tmpk13/pico-step/README.md

# pico-step

Closed-loop stepper driver board: RP2354A + TMC5241 motion controller and
driver (integrated 65 V bridges) + TLE5012B magnetic angle sensor.
USB-C powered logic, separate motor supply (VM) up to 48 V.

The schematic is drawn as text in `tsch/` for the text-schematic tool
`tsch` (set `TSCH` to its binary when it is not on the PATH); `mise run sch`
builds it into `pico-step.kicad_sch`, which is generated and not committed.

```sh
mise run install   # test deps
mise run sch-check # check the tsch/ drawing (fast, no KiCad)
mise run sch       # tsch/ -> pico-step.kicad_sch + sheets, proven with kicad-cli
mise run erc
mise run test
mise run render    # build/tsch/pico-step-<sheet>.png
mise run pcb-sync  # board <- schematic (footprints, values, nets), keeps placement
mise run pcb-place # placement table -> board (overwrites GUI moves)
mise run pcb-dsn   # build/pico-step.dsn for freerouting
mise run pcb-autoroute # FREEROUTING=<launcher or jar> freerouting -> build/pico-step.ses
mise run pcb-ses   # import the session and refill zones
mise run pcb-gnd   # GND stitching vias after routing
mise run pcb-drc
mise run pcb-render # build/pcb-top.png, build/pcb-bottom.png
```

The PCB is a 42 mm NEMA17 back-mount, 2 layers, 0.15 mm rules; the floor
plan is in `notes/pcb.md`.

See `ARCHITECTURE.md` for the block diagram, `BOM.md` for sourced parts,
`PARTS_BY_CHIP.md` for which parts support which chip,
`DIGIKEY.md` for the order list,
`TODO.md` for open work.
