tmpk13/pico-step/NOTES.md

# Notes

One topic per file. Read this index, then only the files the task touches.

- `notes/driver.md`: TMC5241 data sheet and package, running at 48 V, the EVKIT reference design, pin strapping.
- `notes/circuit.md`: the TLE5012B DATA line on the RP2354A SPI, its E5000 variant and PG-DSO-8 land pattern, the USB-C shield pin, power, MCU choice, the RP2354A.
- `notes/schematic.md`: the tsch/ text drawing that builds the schematic, net names and net classes, the swap from the hand-placed schematic, the DigiKey list.
- `notes/pcb.md`: pcbnew scripting under KiCad 10.0.4, the floor plan, the routing result.
