tmpk13/pico-step/digikey_list.csv

Quantity | Part Number | Manufacturer | Customer Reference | Description
1 | SC1511-A4 | Raspberry Pi | U1 | RP2354A MCU with 2 MB flash, QFN-60
1 | AP2112K-3.3TRG1 | Diodes Inc. | U2 | 3.3 V LDO, SOT-23-5
1 | TLE5012BE5000XUMA1 | Infineon | U3 | Magnetic angle sensor, DSO-8
1 | TMC5241ATU+T | Analog Devices | U5 | Stepper controller and driver, 65 V 2 A RMS integrated bridges, TQFN-38-EP 5x7
1 | ABM8-272-T3 | Abracon | Y1 | 12 MHz crystal, CL 10 pF, 3225
1 | AOTA-B201610S3R3-101-T | Abracon | L1 | 3.3u shielded inductor, polarity marked, 2.0x1.6 mm
1 | USB4105-GF-A | GCT | J1 | USB-C receptacle
1 | 1729128 | Phoenix Contact | J2 | 2-pos terminal block, 5.08 mm
1 | PRPC003SAAN-RC | Sullins | J3 | 1x3 header, 2.54 mm (SWD)
1 | B4B-XH-A | JST | J4 | 4-pos XH header
1 | LTST-C191KGKT | Lite-On | D1 | Green LED, 0603
2 | PTS810SJM250SMTR LFS | C&K | SW1 SW2 | Tactile switch
2 | RC0603FR-075K1L | Yageo | R1 R2 | 5.1k 1% 0603
2 | RC0603FR-0727RL | Yageo | R3 R4 | 27R 1% 0603
2 | RC0603FR-071KL | Yageo | R5 R6 | 1k 1% 0603
5 | RC0603FR-1310KL | Yageo | R7 R16 R17 R24 R25 | 10k 1% 0603
1 | RC0603FR-13330RL | Yageo | R8 | 330R 1% 0603
2 | RC0603FR-10100RL | Yageo | R9 R10 | 100R 1% 0603
1 | RC0603FR-07470RL | Yageo | R11 | 470R 1% 0603
1 | RC0603FR-10100KL | Yageo | R12 | 100k 1% 0603
1 | RC0603FR-075K6L | Yageo | R13 | 5.6k 1% 0603
1 | RC0603FR-074K7L | Yageo | R14 | 4.7k 1% 0603
1 | RC0603FR-0712KL | Yageo | R15 | 12k 1% 0603 (RREF, full-scale current)
1 | RC0603FR-0733RL | Yageo | R27 | 33R 1% 0603
1 | GRM188R61A105KA61D | Murata | C1 | 1u 10V X5R 0603
13 | GCM188R71H104KA57D | Murata | C3 C4 C5 C6 C7 C8 C9 C10 C13 C14 C18 C20 C26 | 100n 50V X7R 0603
4 | GRM188R61E475KE11D | Murata | C11 C12 C17 C36 | 4.7u 25V X5R 0603
2 | GCJ188R72A104KA01D | Murata | C21 C22 | 100n 100V X7R 0603
1 | CL10B105KA8VPNC | Samsung | C23 | 1u 25V X7R 0603
2 | CC0603JRNPO9BN150 | Yageo | C15 C16 | 15p 50V C0G 0603
1 | CL10B223KC8WPNC | Samsung | C24 | 22n 100V X7R 0603
1 | GRM188R71A225KE15D | Murata | C25 | 2.2u 10V X7R 0603
2 | C1210C225K1RACTU | KEMET | C33 C34 | 2.2u 100V X7R 1210
1 | GRM21BZ71C106ME15L | Murata | C2 | 10u 16V X7R 0805 (20%)
2 | 63SGV100M10X10.5 | Rubycon | C19 C35 | 100u 63V electrolytic, SMD 10x10.5
