tmpk13/pico-step/TODO_complete.md

# Completed

- RP2040 core, USB-C + 3V3 LDO, TLE5012B on SPI1, VM input + sense: schematic generated, ERC clean.
- Project footprints: Infineon PG-DSO-8 (data sheet land pattern), USB4105 with SH shield pads.
- TMC2240: symbol from data sheet pin table (all 33 pins tested), driver block per Figure 35, motor connector J4.
- MCU swapped RP2040 -> ESP32-C5HF4: symbol from data sheet v1.5 (49 pins tested), supply/crystal/CHIP_PU/BOOT per Espressif reference, RF CLC + Murata diplexer (land pattern from spec CD481-01) + U.FL, TLE5012B moved onto the shared SPI bus, strapping-pin rules tested.
- RF path parts renamed with `_rf` suffix (generator, schematic, PCB, BOM/DigiKey docs); parts-by-chip list in PARTS_BY_CHIP.md; reference consistency tests.
- MCU swapped back ESP32-C5HF4 -> RP2040 (generator, symbols, footprints, tests and docs as before the swap; ESP32 version kept in git at 738db68). DigiKey list and parts-by-chip list redone for RP2040 (56 parts), order list coverage test.
- Hand-placed schematic restored (738db68) with the ESP32 block removed and the RP2040 block pasted below; ERC clean, netlist matches circuit.py apart from the existing hand edits. `mise run sch` now writes to build/, `mise run parity` added.
- Driver swapped TMC2240 -> TMC5160A-TA for VM up to 48 V: symbol from data sheet rev 1.18 (49 pins tested), stock TQFP-48-EP footprint (EP matches the data sheet), 8x CSD19537Q3 bridges with 0.1R sense, Figure 3.1 support parts, per-bridge wiring test. Pasted in place into the hand-placed schematic (A1 sheet), ERC clean, parity shows only the existing hand edits. VM parts re-rated for 48 V (C19 63 V, VM_SENSE 100k/5.6k). DigiKey list 82 parts.
- Dropped: TMC2240 TQFN exposed pad check (part removed).
- MCU swapped RP2040 -> RP2354A (2 MB in-package flash, W25Q128 U4 removed): pinout checked against the RP2350 data sheet, switching core regulator per data sheet 6.3.8 (L1 polarity-marked inductor with a project footprint, R27/C17 VREG_AVDD filter, 4.7u CIN/COUT, C36 on DVDD 23). Swapped in place in the hand-placed schematic (U1 position and uuid kept, old pin labels reused); ERC clean, parity shows only the existing hand edits. DigiKey list 84 parts.
- Bridge FETs 8x CSD19537Q3 -> 4x SQJB68EP dual (one per half bridge) for cost at 5-board quantities; project footprint from Vishay doc 63817 with a data sheet test, stock dual symbol as two units placed where the old singles were (no wires moved). RSENSE 0.1 -> 0.15 (1.6 A RMS full scale) to keep standstill FET heat near 0.7 W; short-detect levels noted. ERC clean, parity shows only the existing hand edits. DigiKey list 80 parts.
- PCB updated from the schematic; every part placed (`tools/pcb_place.py`).
- PCB: TLE5012B on the back at the shaft axis (board center).
- Driver swapped TMC5160A + 4x SQJB68EP -> TMC5241 (integrated 65 V bridges, 2 A RMS): symbol from data sheet rev 0 (39 pins tested), project TQFN-38 footprint from land pattern 90-0076 rev C with 0.3 mm thermal vias (tested), Figure 50 support parts (RREF 12k, 100 V charge pump cap), nSLEEP on GPIO18. Swapped in place in the hand-placed schematic (ERC clean, parity shows only the existing hand edits); board synced from the schematic with the new `pcb-sync` task, placement kept. DigiKey list 63 parts. Old TMC5160A placement table entries, the FET pre-route script and the Vishay footprint removed.
- DigiKey list checked line by line for 5 boards (2026-11-09), including the resistors never searched; eight parts with no stock replaced (DIGIKEY.md).
- Schematic swapped to the tsch/ text drawing (four sheets, RP2354A as two units): `mise run sch` builds and proves it with kicad-cli and refuses to overwrite a schematic saved from KiCad; it matched the hand-placed schematic on all 54 nets before the swap. tools/circuit.py, kicad-vis layout, symbols.py and parity retired; tests read the built netlist. Board synced (net classes follow the new net names), DRC unchanged.
- C11 and C12 set to 4.7u in the schematic and on the board (RP2350 data sheet 6.3.8).
