tmpk13/pico-step/pico-step.kicad_pcb

## KiCad design pico-step.kicad_pcb (2026-11-10)

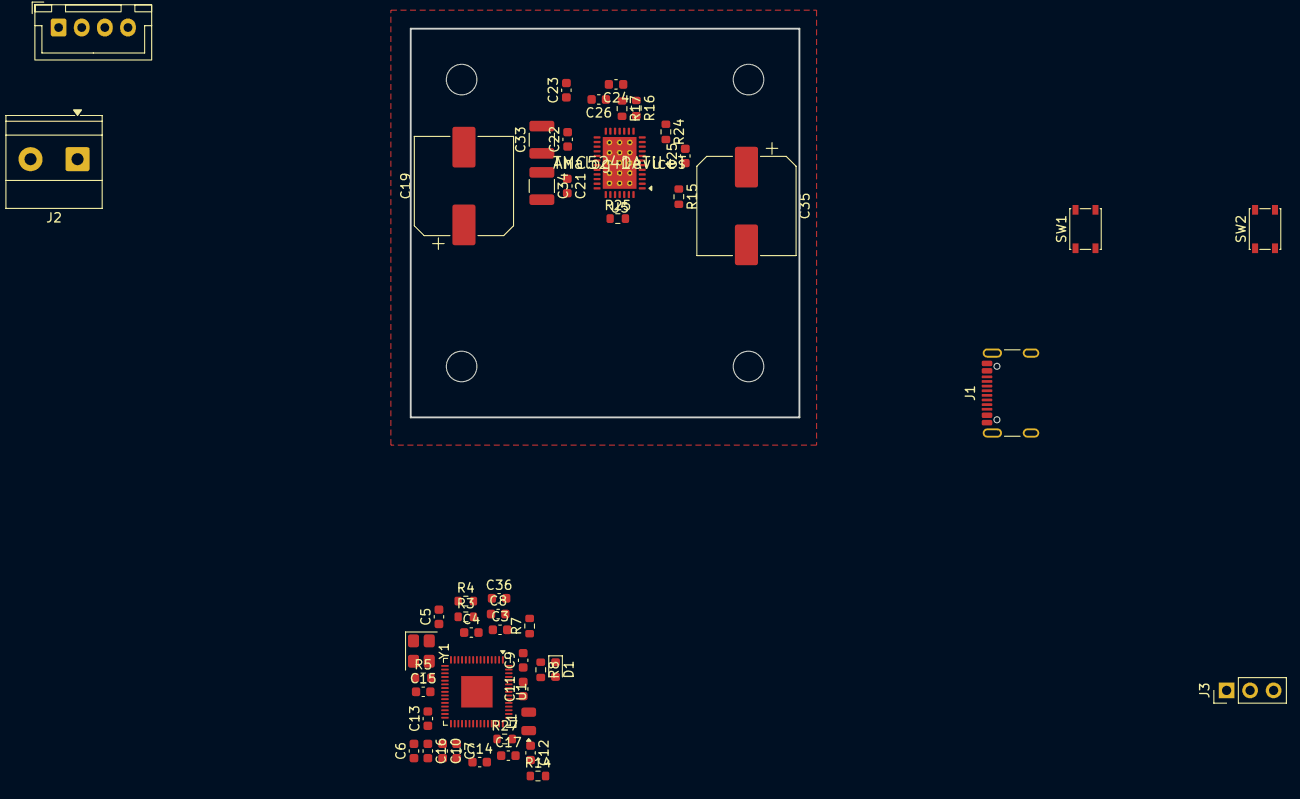
[picture p1: board pico-step.kicad_pcb from above]

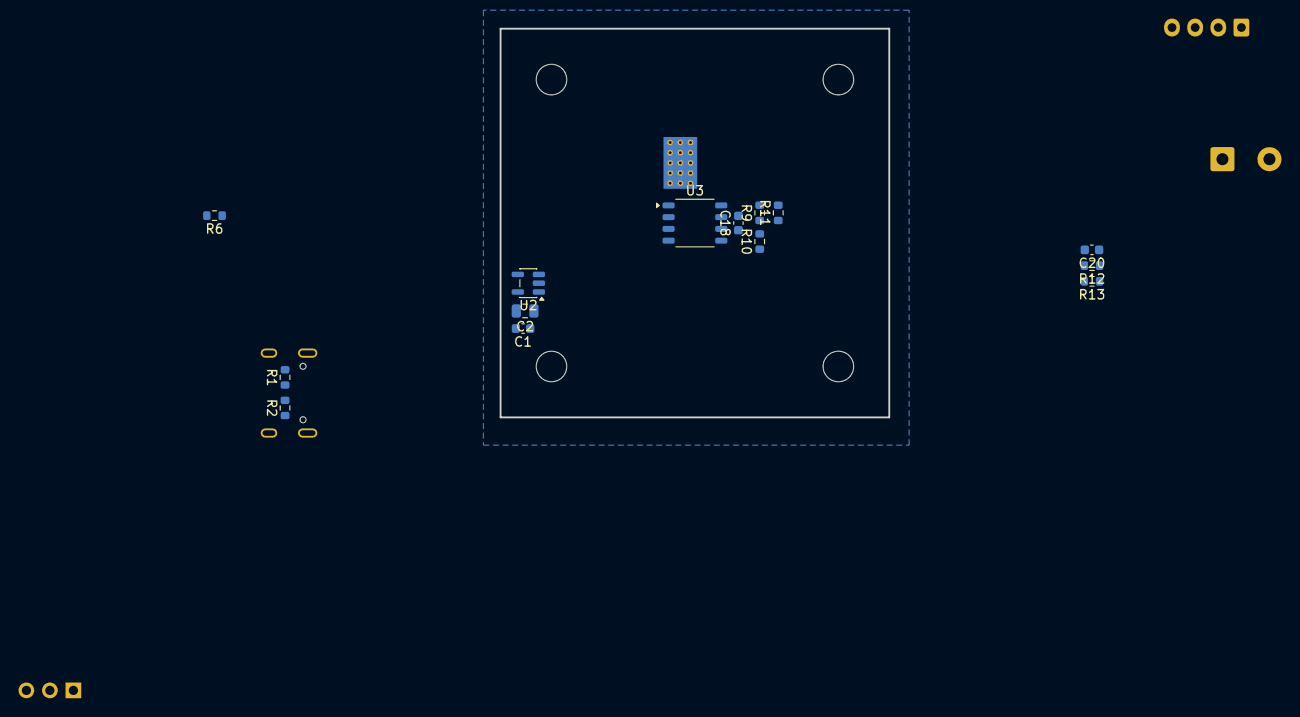
[picture p2: board pico-step.kicad_pcb from below]

Board: 4 copper layers, 42.0 x 42.0 mm, 63 parts (14 on the bottom side), 54 nets, no tracks yet.

Parts:
C1: 1u; C_0603_1608Metric
C2: 10u; C_0805_2012Metric
C3, C4, C5, C6, C7, C8, C9, C10, C13, C14, C18, C20, C26: 100n; C_0603_1608Metric
C11, C12, C17, C36: 4.7u; C_0603_1608Metric
C15, C16: 15p; C_0603_1608Metric
C19, C35: 100u 63V; CP_Elec_10x10.5
C21, C22: 100n 100V; C_0603_1608Metric
C23: 1u 25V; C_0603_1608Metric
C24: 22n 100V; C_0603_1608Metric
C25: 2.2u; C_0603_1608Metric
C33, C34: 2.2u 100V; C_1210_3225Metric
D1: LED; LED_0603_1608Metric
J1: USB-C; USB_C_Receptacle_GCT_USB4105-xx-A_16P_SH
J2: VM; TerminalBlock_Phoenix_MKDS-1,5-2-5.08_1x02_P5.08mm_Horizont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
J3: SWD; PinHeader_1x03_P2.54mm_Vertical
J4: Motor; JST_XH_B4B-XH-A_1x04_P2.50mm_Vertical
L1: 3.3u; L_Abracon_AOTA-B201610
R1, R2: 5.1k; R_0603_1608Metric
R3, R4: 27; R_0603_1608Metric
R5, R6: 1k; R_0603_1608Metric
R7, R16, R17, R24, R25: 10k; R_0603_1608Metric
R8: 330; R_0603_1608Metric
R9, R10: 100; R_0603_1608Metric
R11: 470; R_0603_1608Metric
R12: 100k; R_0603_1608Metric
R13: 5.6k; R_0603_1608Metric
R14: 4.7k; R_0603_1608Metric
R15: 12k; R_0603_1608Metric
R27: 33; R_0603_1608Metric
SW1: BOOTSEL; SW_SPST_PTS810
SW2: RESET; SW_SPST_PTS810
U1: RP2354A; QFN-60-1EP_7x7mm_P0.4mm_EP3.4x3.4mm
U2: AP2112K-3.3; SOT-23-5
U3: TLE5012BE5000; Infineon_PG-DSO-8
U5: TMC5241; ADI_TQFN-38-1EP_5x7mm_P0.5mm_EP3.65x5.6mm_ThermalVias
Y1: 12MHz; Crystal_SMD_3225-4Pin_3.2x2.5mm

Connections:
+1V1: C12.1, C13.1, C14.1, C36.1, L1.1, U1.6 (DVDD), U1.23 (DVDD), U1.39 (DVDD), U1.50 (VREG_FB)
+3V3: C2.1, C3.1, C4.1, C5.1, C6.1, C7.1, C8.1, C9.1, C10.1, C11.1, C18.1, C26.1, R7.1, R16.1, R17.1, R24.1, R27.1, U1.1 (IOVDD), U1.11 (IOVDD), U1.20 (IOVDD), U1.30 (IOVDD), U1.38 (IOVDD), U1.44 (ADC_AVDD), U1.45 (IOVDD), U1.49 (VREG_VIN), U1.53 (USB_OTP_VDD), U1.54 (QSPI_IOVDD), U2.5 (VOUT), U3.6 (VDD), U5.7 (VCC_IO)
/driver/OUT1A: J4.1, U5.29 (OUT1A)
/driver/OUT1B: J4.3, U5.22 (OUT1B)
/driver/OUT2A: J4.2, U5.27 (OUT2A)
/driver/OUT2B: J4.4, U5.24 (OUT2B)
ENC_CSQ: R10.1, U1.17 (GPIO13)
ENC_DATA: R11.1, R14.2, U1.16 (GPIO12)
ENC_IFA: U1.18 (GPIO14), U3.5 (IFA), U5.10 (ENCA)
ENC_IFB: U1.19 (GPIO15), U3.8 (IFB), U5.9 (ENCB)
ENC_IFC: U1.27 (GPIO16), U3.1 (IFC), U5.8 (ENCN)
ENC_SCK: R9.1, U1.14 (GPIO10)
ENC_TX: R14.1, U1.15 (GPIO11)
GND: C1.2, C2.2, C3.2, C4.2, C5.2, C6.2, C7.2, C8.2, C9.2, C10.2, C11.2, C12.2, C13.2, C14.2, C15.2, C16.2, C17.2, C18.2, C19.2, C20.2, C21.2, C22.2, C25.2, C26.2, C33.2, C34.2, C35.2, C36.2, D1.1 (K), J1.A1 (GND), J1.A12 (GND), J1.B1 (GND), J1.B12 (GND), J1.SH (SHIELD), J2.2, J3.2, R1.2, R2.2, R13.2, R15.2, R25.2, SW1.2, SW2.2, U1.47 (VREG_PGND), U1.61 (GND), U2.2 (GND), U3.7 (GND), U5.4 (AIN), U5.6 (AGND), U5.12 (UART_EN), U5.19 (NC), U5.20 (NC), U5.23 (PGND), U5.28 (PGND), U5.31 (NC), U5.32 (NC), U5.38 (CLK), U5.39 (EP), Y1.2 (G), Y1.4 (G)
unnamed: C16.1, R5.2, Y1.3
unnamed: D1.2 (A), R8.1
unnamed: J1.A5 (CC1), R1.1
unnamed: J1.B5 (CC2), R2.1
unnamed: J1.A6 (D+), J1.B6 (D+), R3.1
unnamed: J1.A7 (D-), J1.B7 (D-), R4.1
unnamed: J3.1, U1.24 (SWCLK)
unnamed: J3.3, U1.25 (SWDIO)
unnamed: R6.1, SW1.1
unnamed: C17.1, R27.2, U1.46 (VREG_AVDD)
unnamed: L1.2, U1.48 (VREG_LX)
unnamed: R8.2, U1.37 (GPIO25)
unnamed: R6.2, U1.60 (~QSPI_SS)
unnamed: R7.2, SW2.1, U1.26 (RUN)
unnamed: C15.1, U1.21 (XIN), Y1.1
unnamed: R5.1, U1.22 (XOUT)
unnamed: C1.1, J1.A4 (VBUS), J1.A9 (VBUS), J1.B4 (VBUS), J1.B9 (VBUS), U2.1 (VIN), U2.3 (EN)
unnamed: R10.2, U3.3 (CSQ)
unnamed: R11.2, U3.4 (DATA)
unnamed: R9.2, U3.2 (SCK)
unnamed: C24.1, U5.16 (CPI)
unnamed: C24.2, U5.17 (CPO)
unnamed: R16.2, U5.13 (DIAG0)
unnamed: R17.2, U5.14 (DIAG1_SW)
unnamed: R15.1, U5.3 (IREF)
unnamed: C23.2, U5.18 (VCP)
unnamed: C25.1, U5.5 (VDD1V8)
TMC_CSN: U1.8 (GPIO5), U5.34 (CSN_AD2)
TMC_ENN: R24.2, U1.12 (GPIO8), U5.11 (DRV_ENN)
TMC_REFL: U1.9 (GPIO6), U5.1 (REFL)
TMC_REFR: U1.10 (GPIO7), U5.2 (REFR)
TMC_SCK: U1.4 (GPIO2), U5.35 (SCK_AD1)
TMC_SDI: U1.5 (GPIO3), U5.36 (SDI_AD0)
TMC_SDO: U1.7 (GPIO4), U5.37 (SDO_NAO)
TMC_SLEEPN: R25.1, U1.29 (GPIO18), U5.33 (nSLEEP)
USB_DM: R4.2, U1.51 (USB_DM)
USB_DP: R3.2, U1.52 (USB_DP)
VM: C21.1, C22.1, C23.1, C33.1, C34.1, C35.1, U5.21 (VS), U5.25 (VS), U5.26 (VS), U5.30 (VS)
VM_IN: C19.1, J2.1, R12.1
VM_SENSE: C20.1, R12.2, R13.1, U1.40 (GPIO26/ADC0)
