tmpk13/pico-step/(commit log)

2026-10-03 RP2040 + TLE5012B schematic, project footprints, tests
    Generated schematic (kicad-vis) for the RP2040 core, USB-C/3V3 supply,
    TLE5012B angle sensor on SPI1 and VM sense. Project footprint library with
    the Infineon PG-DSO-8 land pattern and a USB4105 copy whose shield pads
    match the embedded symbol. TMC2240 block pending its data sheet.
    [pico-step.kicad_pcb, pico-step.kicad_sch]
2026-10-03 Add TMC2240 driver: symbol, footprint, schematic block
    Symbol generated from the data sheet TQFN32 pin table and checked against
    its pin configuration drawing (tests cover all 33 pins). Driver support
    parts per the standard application circuit, RREF 12k, SLEEPN on GPIO18,
    encoder inputs shared with the TLE5012B IIF lines, JST XH motor connector.
    Footprint copies the T3255-3 TQFN-32 pattern; the T3255-5 exposed pad size
    is still to be confirmed.
    [pico-step.kicad_sch]
2026-10-04 Swap RP2040 for ESP32-C5HF4
    - ESP32-C5HF4 symbol from data sheet v1.5 Figure 2-2 / Table 2-3, stock
    QFN-48 6x6 footprint with thermal vias.
    - Support circuit per the ESP32-C5 Hardware Design Guidelines: per-pin
    decoupling, VDDA1/2 LC filter, 48 MHz crystal with series inductor,
    CHIP_PU RC with RESET, BOOT on GPIO28, UART0 header, 22R USB series.
    - RF: CLC match on ANT_2G/ANT_5G, Murata LFD182G45DCHD481 diplexer
    (symbol and land pattern from spec CD481-01), antenna CLC, U.FL.
    - Remove the W25Q128 flash and 12 MHz crystal (flash is in package).
    - TLE5012B moves onto the shared SPI bus in 3-wire mode; the 4.7k TX
    workaround is gone.
    - GPIO plan keeps TMC2240 DIAG0 off the boot straps;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
    [pico-step.kicad_sch]
2026-10-04 Add DigiKey order list
    [digikey_list.csv]
2026-10-05 Suffix RF path parts with _rf, add parts-by-chip list
    Antenna-path parts (2.4/5 GHz CLC matches, diplexer, antenna CLC, U.FL)
    renamed C29_rf..C34_rf, L3_rf, L4_rf, R18_rf, FL1_rf, J5_rf in the
    generator and docs. PARTS_BY_CHIP.md groups all 69 parts by the chip they
    support. tests/test_refs.py checks the suffix set against the RF nets and
    the schematic/PCB references against the generator.
    [digikey_list.csv]
2026-10-05 Adjusting schematic
    [pico-step.kicad_pcb, pico-step.kicad_sch]
2026-10-06 Snapshot ESP32-C5 schematic and PCB placement before RP2040 swap-back
    [pico-step.kicad_pcb, pico-step.kicad_sch]
2026-10-06 Swap ESP32-C5HF4 back to RP2040
    - Restore generator, symbols, footprints and footprint tests from b46301c;
    drop the Murata diplexer footprint. Schematic regenerated: 56 parts,
    ERC clean.
    - DigiKey order list and parts-by-chip list redone for the RP2040 BOM;
    test that the order list covers every reference once.
    - Drop the RF suffix test. The PCB still carries the ESP32-C5 placement
    and needs Update PCB from Schematic (TODO).
    [digikey_list.csv, pico-step.kicad_sch]
2026-10-12 Restore hand-placed schematic, swap ESP32 block for RP2040 in place
    - Schematic from 738db68 (GUI layout and hand edits kept); ESP32-C5,
    RF section and their wiring removed; RP2040 block laid out alone and
    placed below. ERC clean; netlist matches circuit.py except the
    existing hand edits (VM split, DIAG0/DIAG1 unwired).
    - mise run sch writes build/pico-step.gen.kicad_sch so it cannot
    overwrite the layout; mise run parity lists netlist differences.
    [pico-step.kicad_sch]
2026-10-12 Swap TMC2240 for TMC5160A-TA, rate motor supply for 48 V
    TMC5160A gate driver and motion controller with eight CSD19537Q3
    (100 V) MOSFETs, 0.1R sense per phase (2.3 A RMS full scale) and the
    data sheet's standard application circuit; VSA tied to VS. SD_MODE on
    GPIO18 with a pull-down (motion controller + TLE5012B encoder by
    default), DRV_ENN pull-up added (no internal pull on this part).
    Motor supply parts re-rated: C19 100u 63V, VM_SENSE 100k/5.6k.
    Driver block pasted in place into the hand-placed schematic (sheet now
    A1); ERC clean, parity shows only the existing hand edits. Symbol,
    pin-name and per-bridge wiring tests, DigiKey list and docs updated.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
    [digikey_list.csv, pico-step.kicad_sch]
2026-10-12 Snapshot hand schematic edits before RP2354A swap
    [pico-step.kicad_sch]
2026-10-12 Swap RP2040 for RP2354A, drop external QSPI flash
    - U1 RP2354A (SC1511-A4, QFN-60, 2 MB in-package flash); U4 W25Q128
    removed, QSPI data/clock pins left open, BOOTSEL kept on QSPI_SS.
    - Switching core regulator per RP2350 data sheet 6.3.8: L1 polarity-
    marked AOTA-B201610S3R3-101-T (project footprint, pad 1 = dot = VOUT),
    4.7u CIN/COUT, R27/C17 33R/4.7u VREG_AVDD filter, C36 4.7u on DVDD 23.
    - Pinout checked against the data sheet pin tables; GPIO assignments
    unchanged.
    - Swapped in place in the hand-placed schematic (U1 position and uuid
    kept, old pin labels reused). ERC clean; parity shows only the
    existing hand edits. DigiKey list 84 parts.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
    [digikey_list.csv, pico-step.kicad_sch]
2026-10-12 Swap bridge FETs to 4x SQJB68EP duals, RSENSE 0.15
    Eight CSD19537Q3 become four Vishay SQJB68EP dual N-MOSFETs, one per
    half bridge (FET1 high side, FET2 low side), for cost at 5-board
    quantities. New PowerPAK SO-8L Dual footprint from Vishay doc 63817 with
    a data sheet test; the stock Q_Dual_NMOS_S1G1S2G2D2D1 symbol is placed
    as two units where the old singles stood, so no schematic wires moved.
    RSENSE 0.1 -> 0.15 Ohm (1.6 A RMS full scale) keeps worst-case
    standstill FET dissipation near 0.7 W. Short-detect levels for the
    higher on-resistance are recorded in NOTES and TODO.
    [digikey_list.csv, pico-step.kicad_sch]
2026-10-12 Place the PCB: power stage on top, MCU block on the back
    Floor plan for the 42 mm NEMA17 back-mount board: FET row under the
    motor connector, TMC5160A below it shifted right so its thermal vias
    clear the angle sensor on the back, sense resistors between them, bulk
    capacitors on the left and right edges, VM terminal and SWD header on
    the bottom edge, RP2354A with its regulator and decoupling on the back.
    tools/pcb_place.py holds the placement table and applies it.
    [pico-step.kicad_pcb, pico-step.kicad_sch]
2026-10-12 Pre-route the power stage, add net classes and PCB mise tasks
    Locked tracks for the FET source links, half bridge outputs, sense
    resistor links and VM feeds, a VM pour on the back with vias into the
    drain paddles, wider thermal vias under the driver. Net classes power
    (0.8 mm) and gate (0.4 mm) for the autorouter.
    [pico-step.kicad_pcb]
2026-10-12 Rotate the MCU toward the driver, 0.15 mm rules, DSN export with VM keepout
    [pico-step.kicad_pcb]
2026-10-12 Freerouting profile workaround, PCB task docs, board floor plan diagram
2026-10-12 Autorouted signals with freerouting, GND stitching, routing notes
    Power stage hand-routed and locked, signals from freerouting (0.15 mm
    rules); 35 signal connections and 18 GND items still open, see
    NOTES.md Routing result and TODO.md.
    [pico-step.kicad_pcb]
2026-10-12 Take the 60-pass freerouting result, hole-aware GND stitching
    21 signal connections and 30 GND items remain open; no clearance,
    short, edge or hole violations.
    [pico-step.kicad_pcb]
2026-10-22 Snapshot hand schematic and board edits before TMC5241 swap
    Schematic blocks rearranged in the GUI, board re-placed with the routing
    removed, zone and net class settings changed in the project.
    [pico-step.kicad_pcb, pico-step.kicad_sch]
2026-10-22 Swap TMC5160A + external FETs for TMC5241
    TMC5241 motion controller and driver with integrated 65 V bridges and
    current sensing (2 A RMS at 24 V, 1.7 A at 48 V) replaces the TMC5160A,
    four SQJB68EP duals, sense resistors and gate supply parts. Symbol from
    data sheet rev 0 (all 39 pins tested); project TQFN-38 footprint from
    ADI land pattern 90-0076 rev C with 0.6/0.3 mm thermal vias (tested).
    Figure 50 support parts: RREF 12k (2.05 A RMS full scale), 22n 100V
    charge pump cap, 2.2u VDD1V8. nSLEEP on GPIO18 with the old SD_MODE
    pull-down, REFL/REFR on GPIO6/7, OV unconnected (brake chopper TODO).
    Schematic: block swapped in place in the hand-placed sheet, ERC clean,
    parity shows only the exis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
    [digikey_list.csv, pico-step.kicad_pcb, pico-step.kicad_sch]
2026-10-22 Note TMC5241-EVKIT VS decoupling, bulk and brake reference
    ADI's eval board ties all four VS pins to one net and places one
    100n + 1u pair at each end of the VS/OUT pin row, nothing at the middle
    pair; the per-bridge VS grouping in the comments was an inference and
    now follows that placement. Also recorded: its charge pump values (22n
    100V CPI-CPO, as here), two 150u bulk caps, SMCJ54A TVS and brake output.
2026-11-10 Restock DigiKey list: replace eight parts with no DigiKey stock
    Checked every line for a 5-board run on 2026-11-09. All parts are
    Active; eight had zero stock in every packaging and get same-package,
    same-rating replacements (Yageo -13/-10 reel codes for 10k, 330R, 100R,
    100k; GCJ188R72A104KA01D, CL10B105KA8VPNC, CL10B223KC8WPNC, and
    GRM21BZ71C106ME15L at 20% for C2). Closes the unsearched-resistor TODO
    and adds one for C11/C12, which the schematic and board still carry at
    1u while circuit.py and the list have 4.7u.
    [digikey_list.csv]
2026-11-10 Redraw the schematic as text with tsch
    tsch/ holds the hand schematic drawn again for the text-schematic tool:
    four sheets (power, mcu, encoder, driver), the RP2354A as a supply unit
    and an IO unit. tsch verify passes (KiCad reads back the drawn netlist,
    ERC 0 errors, every text inside its cells), and all 54 multi-pin nets
    equal the hand schematic's pin for pin. C11/C12 are drawn at the 4.7u the
    TODO asks for; the hand schematic still reads 1u.
    parity.py --tsch compares the hand schematic with the tsch build (nets,
    then value, footprint and MPN per part); mise tasks tsch, tsch-check,
    tsch-parity and tsch-render run it, with TSCH pointing at the binary.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
2026-11-10 Snapshot hand schematic and board edits before the tsch swap
    The hand-placed schematic, board placement and zone settings as they
    stood in the working tree, kept in history before tsch/ becomes the
    schematic source.
    [pico-step.kicad_pcb, pico-step.kicad_sch]
2026-11-10 Make tsch/ the schematic source
    mise run sch (tools/tsch_sch.py) builds tsch/project.toml, proves it with
    kicad-cli and copies pico-step.kicad_sch, its four sheets and
    tsch.kicad_sym into the project root; those are generated and ignored.
    tsch's own .kicad_pro is never copied, and a schematic saved from KiCad
    since generation is not overwritten without --force. erc, test and
    pcb-sync depend on sch.
    tools/circuit.py, its kicad-vis layout, symbols.py, set_erc.py and the
    parity tool are retired. Tests read the netlist KiCad exports from the
    built schematic: references against board and DigiKey list, footprint
    pads, TMC5241 pin names and support circuit, plus the overwrite guard.
    The J2 input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
    [pico-step.kicad_pcb, pico-step.kicad_sch]
